fitushar/Development-of-a-Modular-Biopotential-Amplifier-Trainer-for-Biomedical-Instrumentation-Laboratory-Ex/Presentation/RTR presentation.pdf

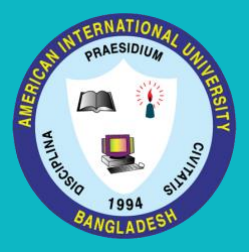
[picture p86: figure]

# Development of A Multichannel Modular Universal Biopotential Amplifier Train (RTR Module)

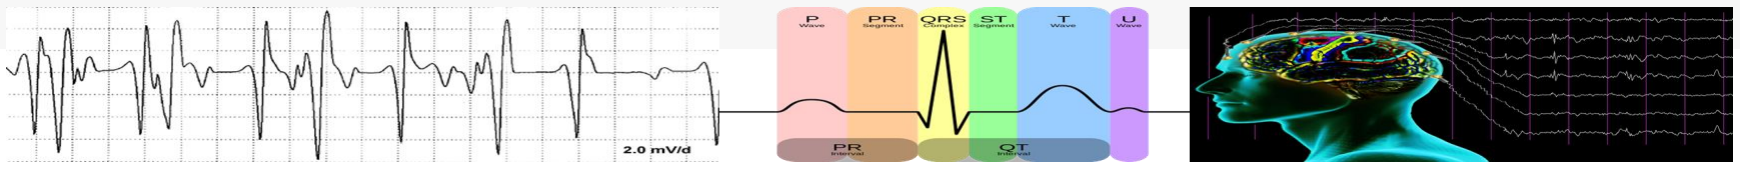
[picture p87: figure]

# SUPERVISOR

## Group Members

2

# EXTERNAL SUPERVISOR

# GROUP-35 , Summer Defense 2O16

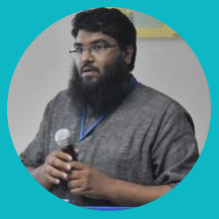
[picture p88: figure]

Saiful Islam Khan
Lecturer, Faculty of Engineering, AIUB.

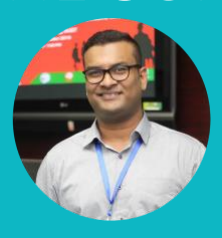
[picture p89: figure]

Chowdhury Akram Hossain
Senior Assistant Professor, Faculty of Engineering, AIUB.

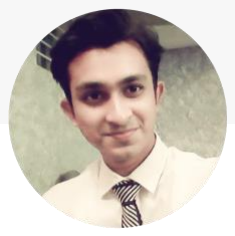
[picture p90: figure]

MD. Amirul Islam Rokan
ID:13-23295-1

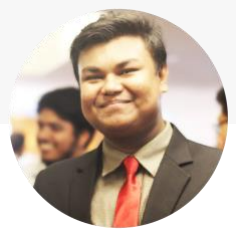
[picture p91: figure]

Fakrul Islam Tushar
ID:13-23244-1

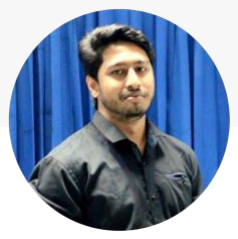
[picture p92: figure]

Rupu Chowdhury
ID:13-23143-1

# Contents

3 | Biomedical Engineering
| Biopotentials
| Available Biopotential LAB Equipment Problem
| Project Idea
| Block Diagram of the project
| RTR Module Configuration
| Hand on skill Enhancement
| Output of ECG,EEG and EMG
| Cost of the Project
| Software Alternative
| Limitation & Solution
| Student Survey

### - Reference

# Biomedical Engineering

### Biomedical engineers (BME) apply advance engineering designing knowledge to

solve medical challenges and design health care devices problems[1].

## ✓ Engineering your health ✓ Designing artificial limbs

✓ Designing medical equipment and so on….

4

# Biopotential

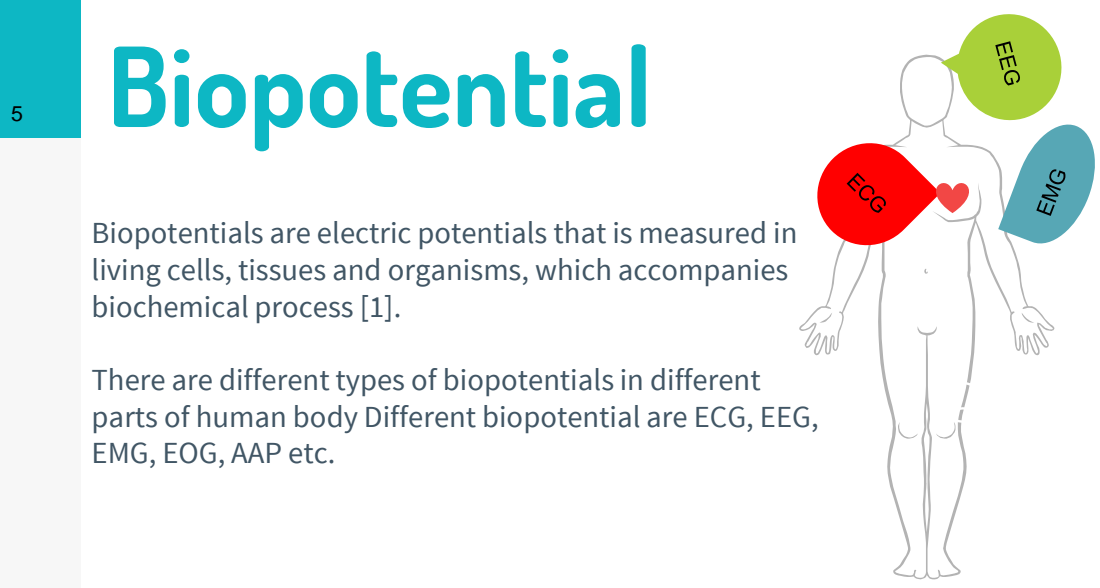
[picture p93: page 5]

Biopotentials are electric potentials that is measured in
living cells, tissues and organisms, which accompanies
biochemical process [1].

There are different types of biopotentials in different
parts of human body Different biopotential are ECG, EEG,
EMG, EOG, AAP etc.

# Biopotential

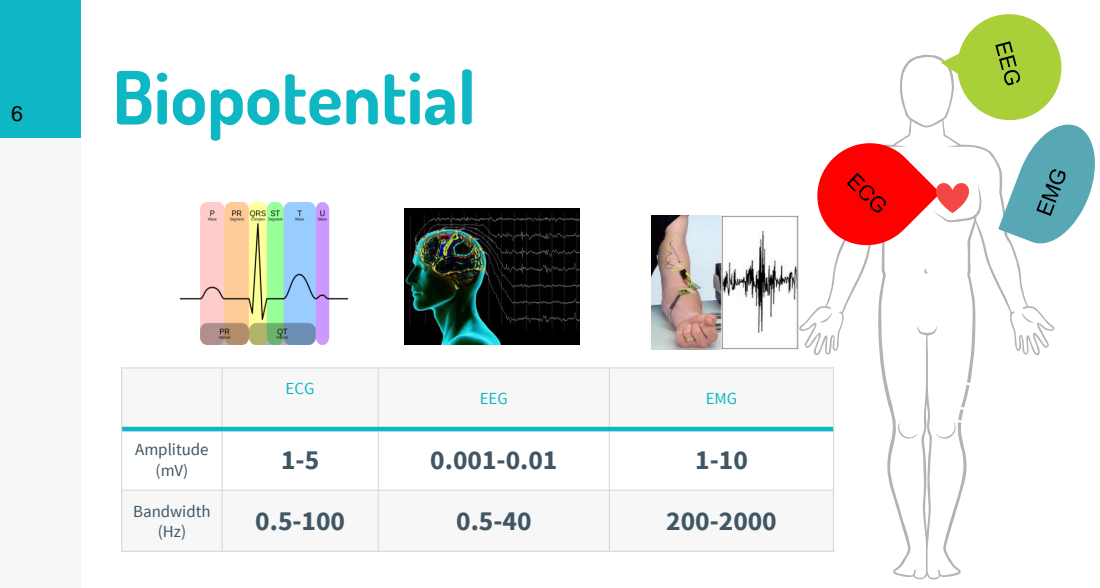
[picture p94: page 6]

ECG | EEG | EMG

Amplitude (mV) | 1-5 | 0.001-0.01 | 1-10

Bandwidth (Hz) | 0.5-100 | 0.5-40 | 200-2000

”

# “Problems with the biopotential lab’s equipment”

7

# Available Laboratory Devices

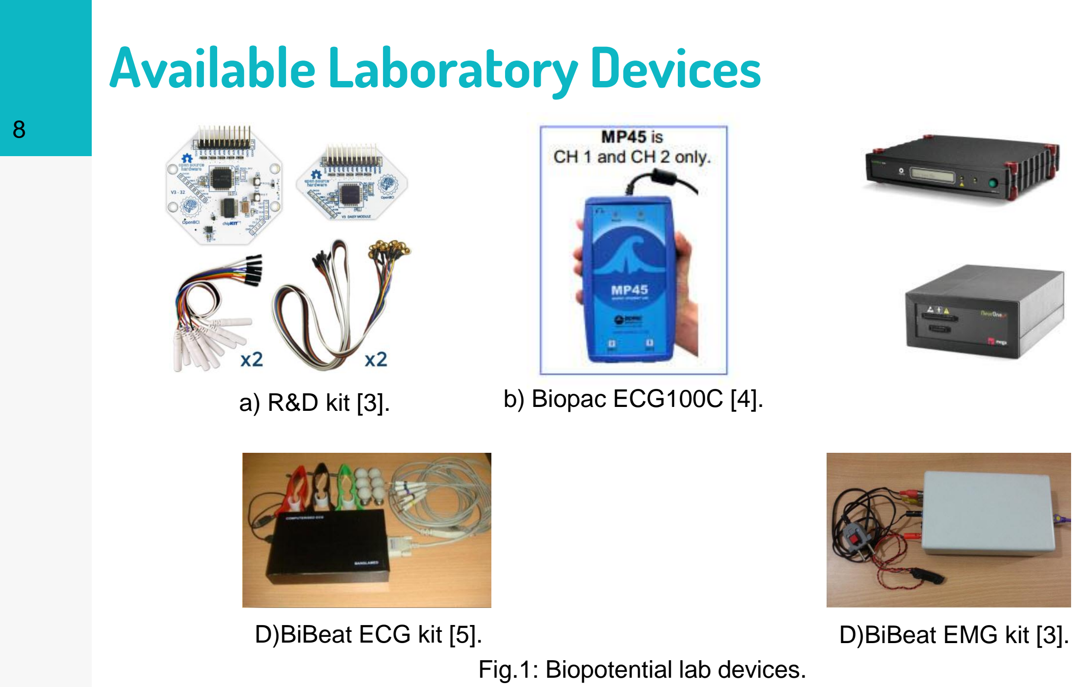
[picture p95: page 8]

8

Fig.1: Biopotential lab devices.

a) R&D kit [3]. | b) Biopac ECG100C [4].
D)BiBeat ECG kit [5]. | D)BiBeat EMG kit [3].

# 9 High Cost

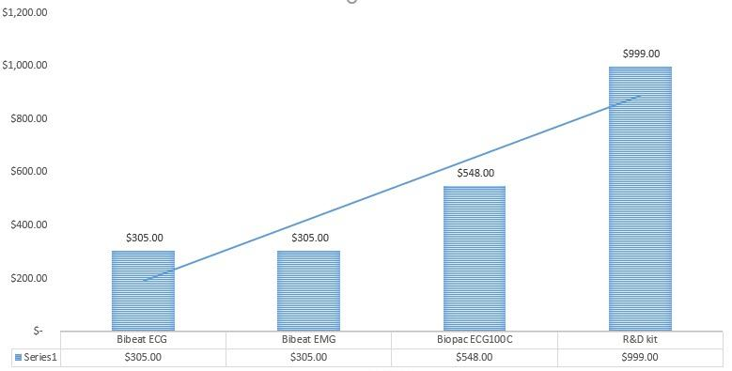
[picture p96: figure]

# IDEA OF THE PROJECT

10
1 | 2 | 3

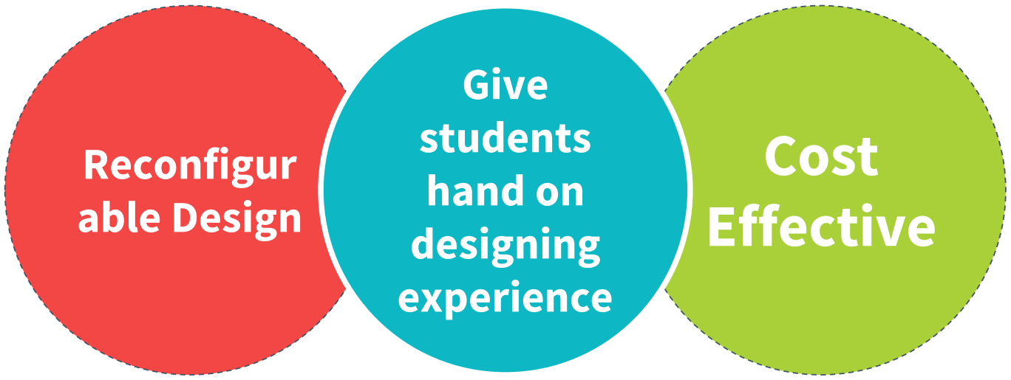
[picture p97: figure]
Reconfigur able Design; Cost Effective; Give students hand on designing experience

# BLOCK DIAGRAM OF 11 THE PROJECT


Fig.2: Block diagram of the project.

# BLOCK DIAGRAM OF THE RTR 12 MODULE

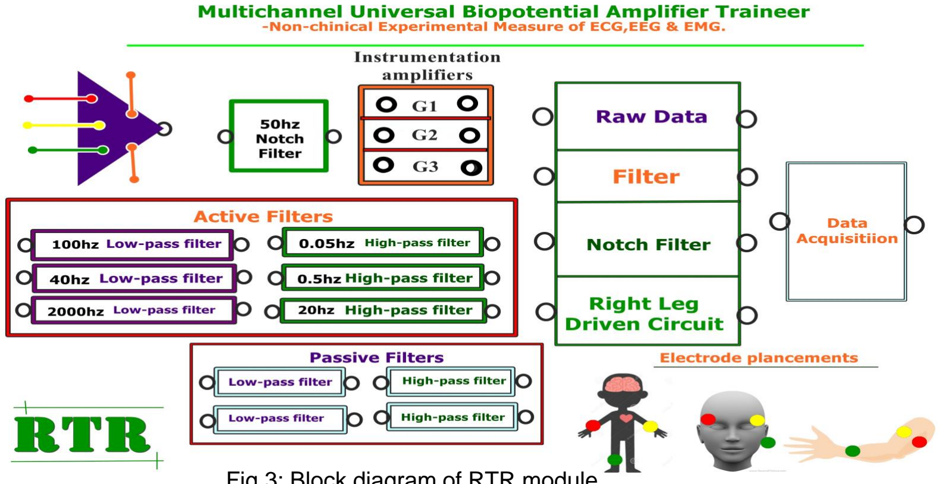
[picture p98: figure]

Fig.3: Block diagram of RTR module.

# BLOCK DIAGRAM OF THE 13 CONFIGURATION

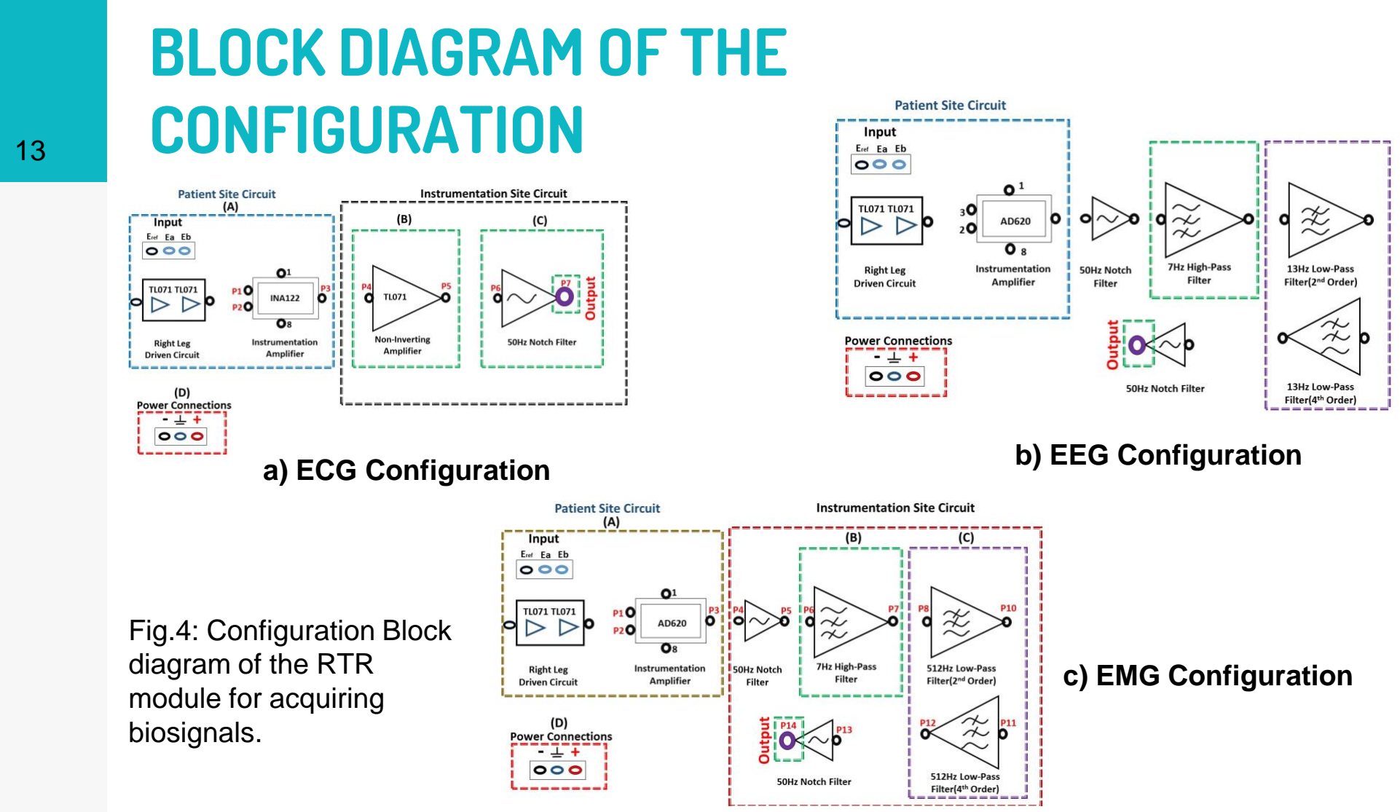
[picture p99: page 13]

a) ECG Configuration | b) EEG Configuration
c) EMG Configuration

Fig.4: Configuration Block diagram of the RTR
module for acquiring
biosignals.

# DESIGNED 14 PROTOTYPE

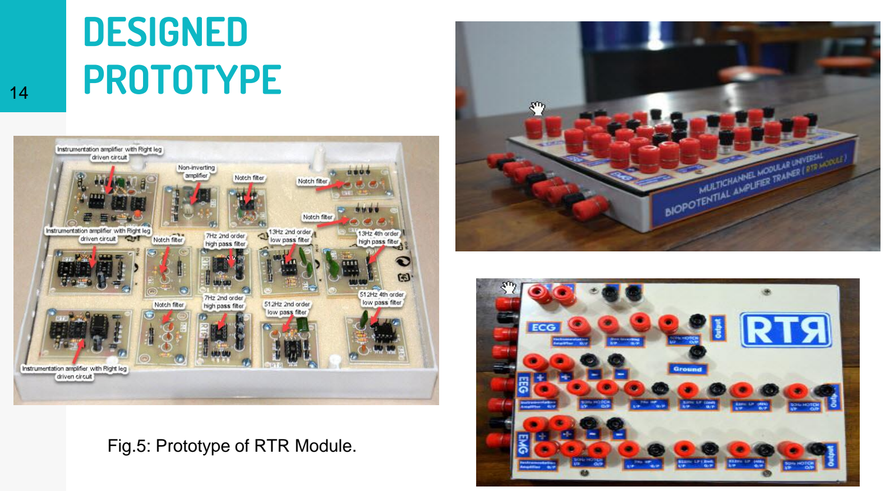
[picture p100: page 14]

Fig.5: Prototype of RTR Module.

# HAND-ON DESIGNING 15 EXPERIENCE

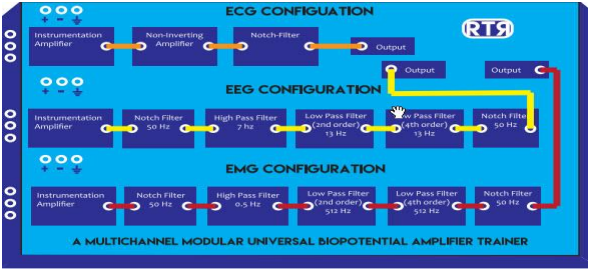
[picture p101: figure]

Fig.6: Connection configuration.

# HAND-ON DESIGNING 16 EXPERIENCE

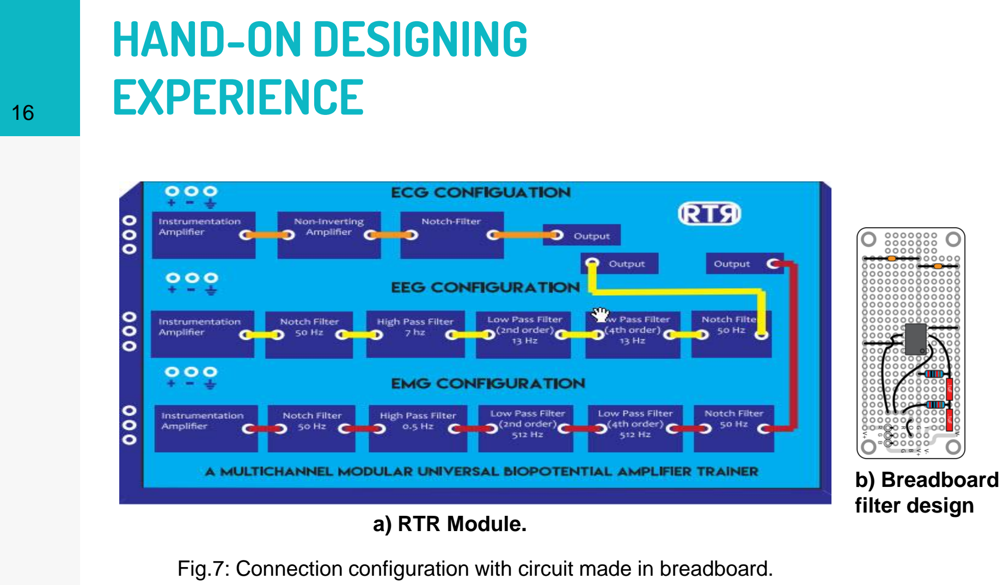
[picture p102: page 16]

Fig.7: Connection configuration with circuit made in breadboard.

a) RTR Module.
b) Breadboard
filter design

# 17 ECG MEASUREMENT

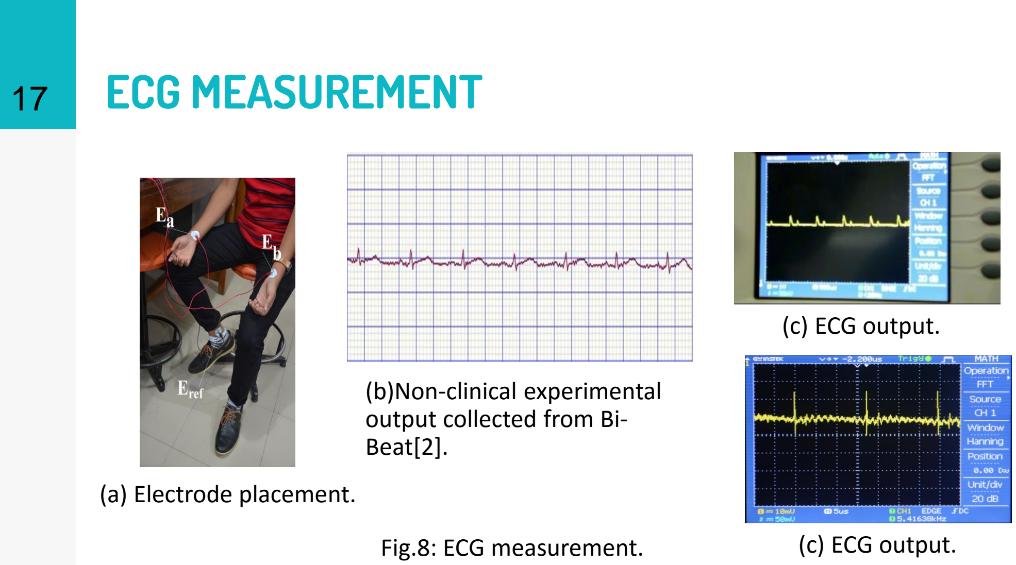
[picture p103: page 17]

(a) Electrode placement.
(c) ECG output.

Fig.8: ECG measurement.

## (b)Non-clinical experimental output collected from Bi-

Beat[2].

(c) ECG output.

# 18 EEG MEASUREMENT

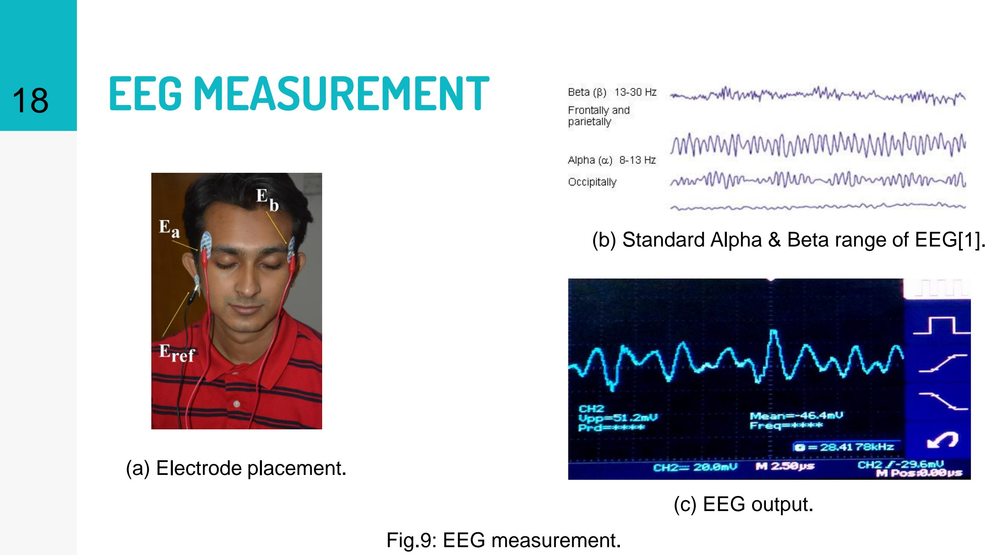
[picture p104: page 18]

(a) Electrode placement.
(c) EEG output.

Fig.9: EEG measurement.

(b) Standard Alpha & Beta range of EEG[1].

# 19 EMG MEASUREMENT

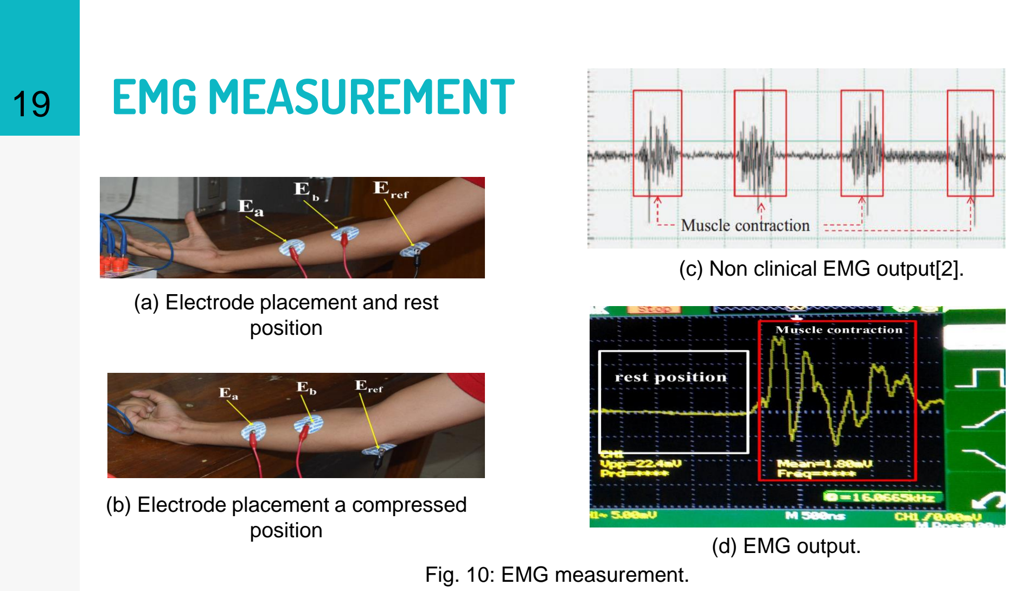
[picture p105: page 19]

(b) Electrode placement a compressed position
(d) EMG output.
Fig. 10: EMG measurement.
(a) Electrode placement and rest position
(c) Non clinical EMG output[2].

20 | Cost
Equipment | Cost (TAKA)
PCB Printout and Soldering | 3500
RTR Box | 2500
Op-Amps | 2000
Circuit Equipment | 2000
Electrodes and other wires | 1000
Data Acquisition system | 800
Total | 11800TK / $143

# 21 Target achievements

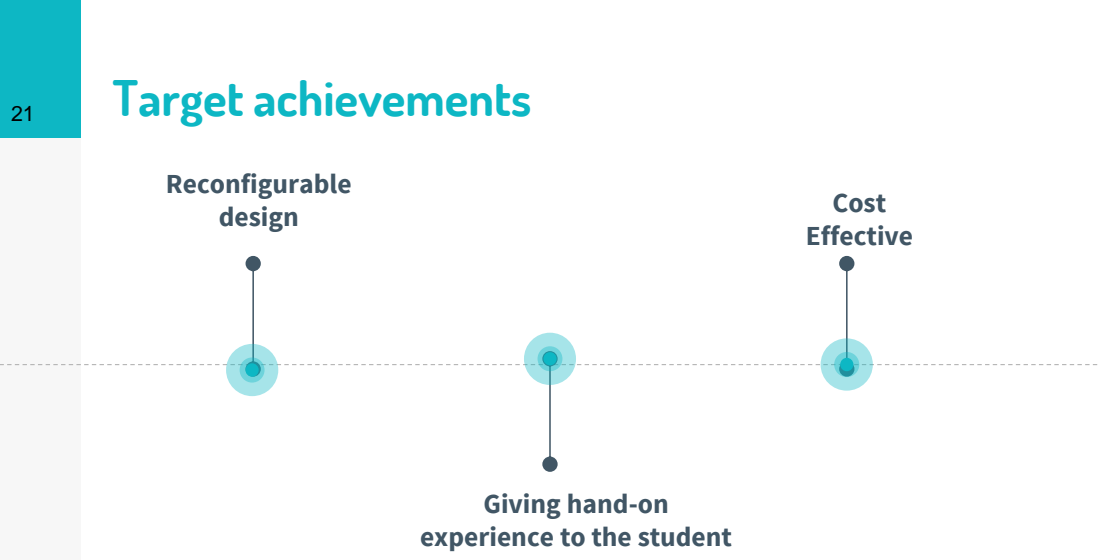
[picture p106: page 21]
Reconfigurable design; Cost Effective

Giving hand-on
experience to the student

# 22 SOFTWARE ALTERNATIVE

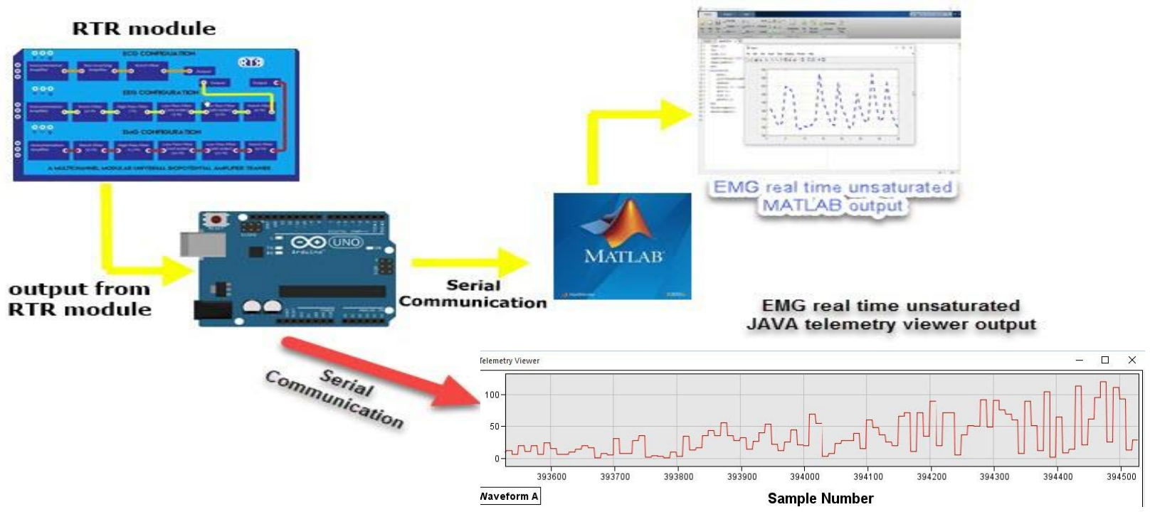
[picture p107: figure]

Fig.11: Software alternative.

# LIMITATION & SOLUTION

## For medical equipment is good to have the tolerance level of 0.1% ,where we had used resistance of 5%-10% tolerance due to the lacking of SMD

implementation limitation.

# For over come the limitation we are coming with the

# “RTR module 2.0”

23

”

# “RTR MODULE 2.O”

24

# Cost Approximately $250

## #Start a small startup # National Patent #Catch the marker

50

# Students

# 1 to 5 Questions score 6

# Questions

25

# Survey on Student

👦👧

?

🔑

# 26 SURVEY QUESTIONS

1. The “RTR Module” will improve medical instrumentations
knowledge when compared to traditional lecture courses. | 1 | 2 | 3 | 4 | 5
2. This “RTR Module” will provide more practical knowledge
and technologies for medical instrumentations. | 1 | 2 | 3 | 4 | 5
3. You can relate the RTR Modulesinstrumentation with
your theoretical knowledge. | 1 | 2 | 3 | 4 | 5
4. RTR Modulesstep by step filtering options give you more
clear ideas about bio-amplification and filtering. | 1 | 2 | 3 | 4 | 5
5. RTR Module is giving more improved in hands-on skills of
medical instrument design. | 1 | 2 | 3 | 4 | 5
6. This “RTR module” will make you pay more affords
on this course. | 1 | 2 | 3 | 4 | 5

Strongly
Disagreed

Strongly
Agreed

# 27 SURVEY RESULT

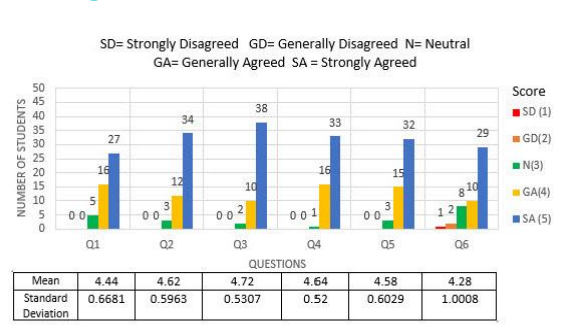
[picture p108: figure]

# Reference

28 | [1] The Biosignal How-To [BPM biosignals]. 2016. The Biosignal How-To [BPM biosignals]. [ONLINE] Available at: http://biosignals.berndporr.me.uk/doku.php?id=start. Accessed 01 May 2016.
[2] BiBeat. 2016. 12 lead ECG | BiBeat. [ONLINE] Available at: http://bibeat.com/product/12-lead-
| ecg/. Accessed 02 May 2016.
| [3]O. O. Store, "R&D kit (16-channel) — 32bit, daisy, & accessories," OpenBCI Online Store, 2016. [Online]. Available: http://shop.openbci.com/collections/frontpage/products/openbci-16-channel-r-d- kit?variant=785215991. Accessed: Dec. 28, 2016.
[4] [Online]. Available: https://www.biopac.com/product/ecg-electrocardiogram-amplifier/. Accessed:
| Dec. 28, 2016.
[5] M. E. Ltd, "Mega electronics Ltd," 2016. [Online]. Available: http://www.megaemg.com/products/.
| Accessed: Dec. 28, 2016.

# Thank you !!!

# ANY Question ???
