fitushar/Development-of-a-Modular-Biopotential-Amplifier-Trainer-for-Biomedical-Instrumentation-Laboratory-Ex/images/Slide1.PNG

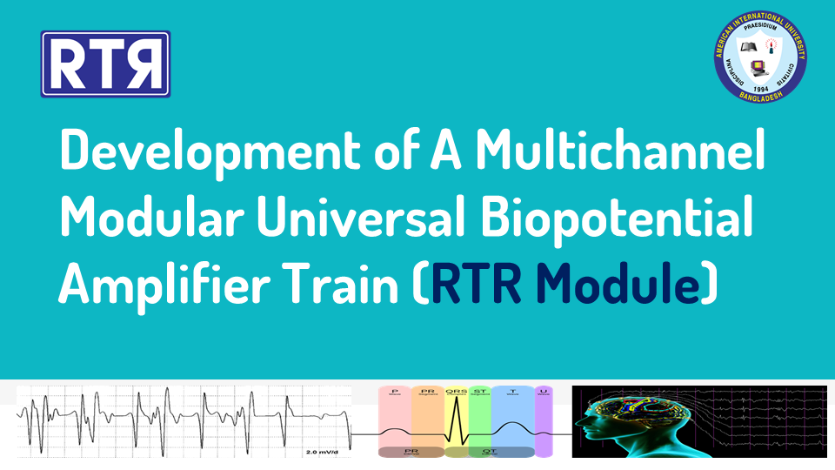
images/Slide1.PNG
