fitushar/Development-of-a-Modular-Biopotential-Amplifier-Trainer-for-Biomedical-Instrumentation-Laboratory-Ex/images/Slide11.PNG

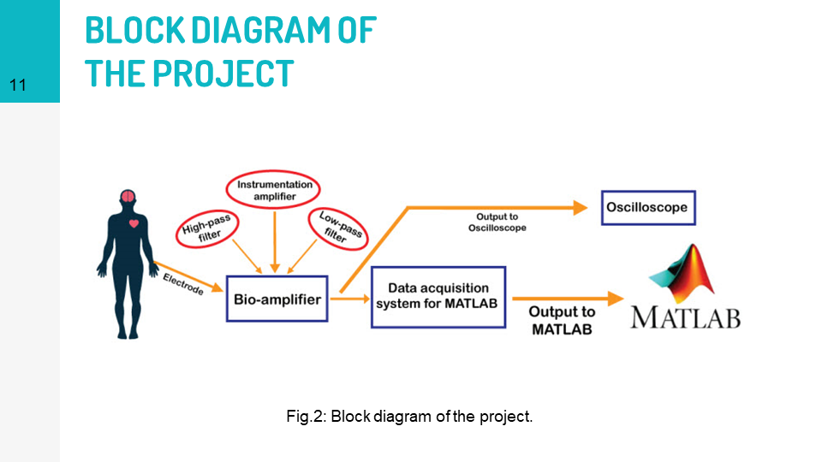
images/Slide11.PNG
