fitushar/Development-of-a-Modular-Biopotential-Amplifier-Trainer-for-Biomedical-Instrumentation-Laboratory-Ex/poster/Poster(RTR)-final.png

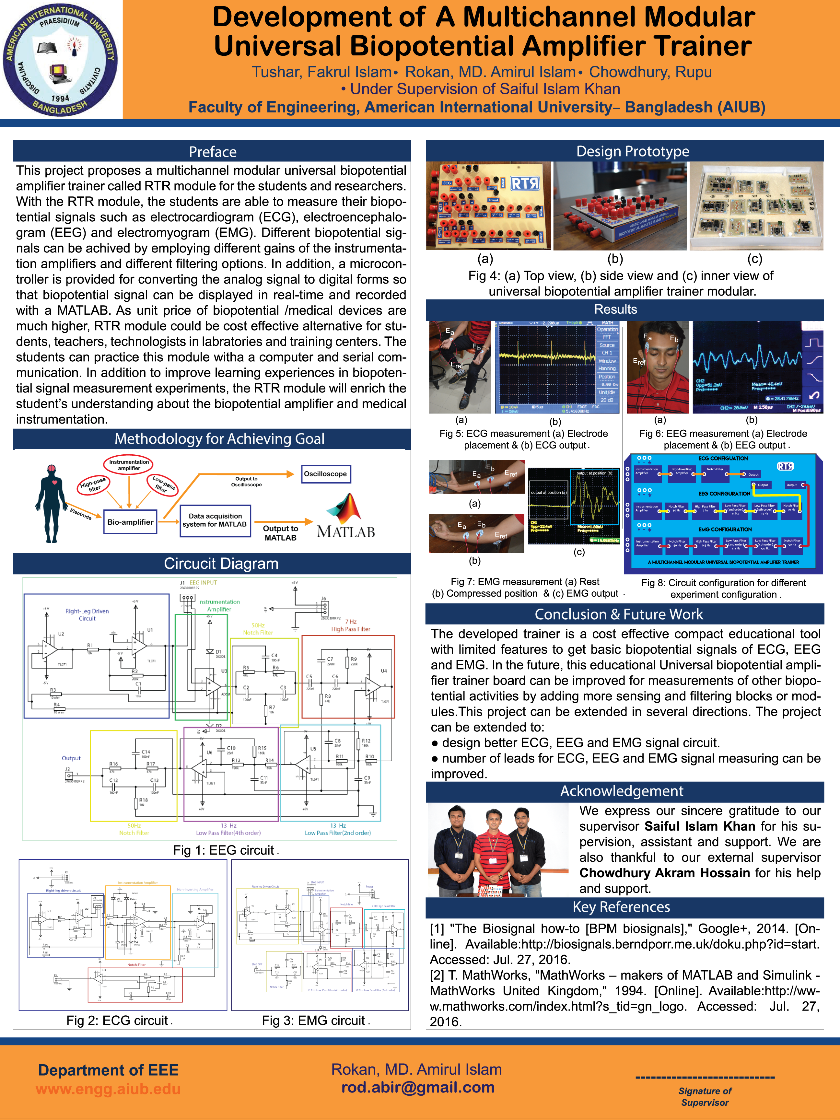
poster/Poster(RTR)-final.png
